lsauer1/ITP-470-Smart-Home/photos/vccPin.jpg

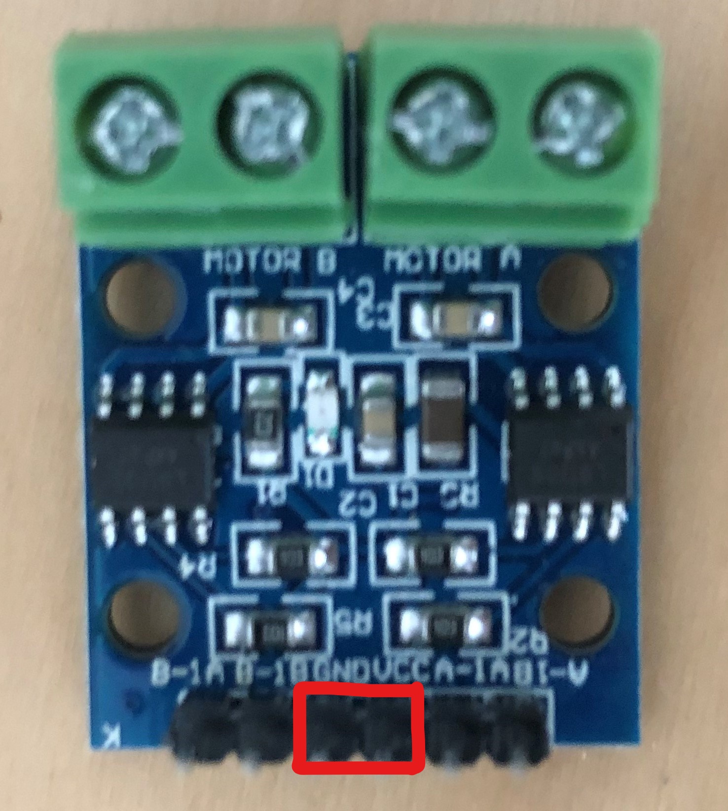
photos/vccPin.jpg
