lsauer1/ITP-470-Smart-Home/photos/motorPin.jpg

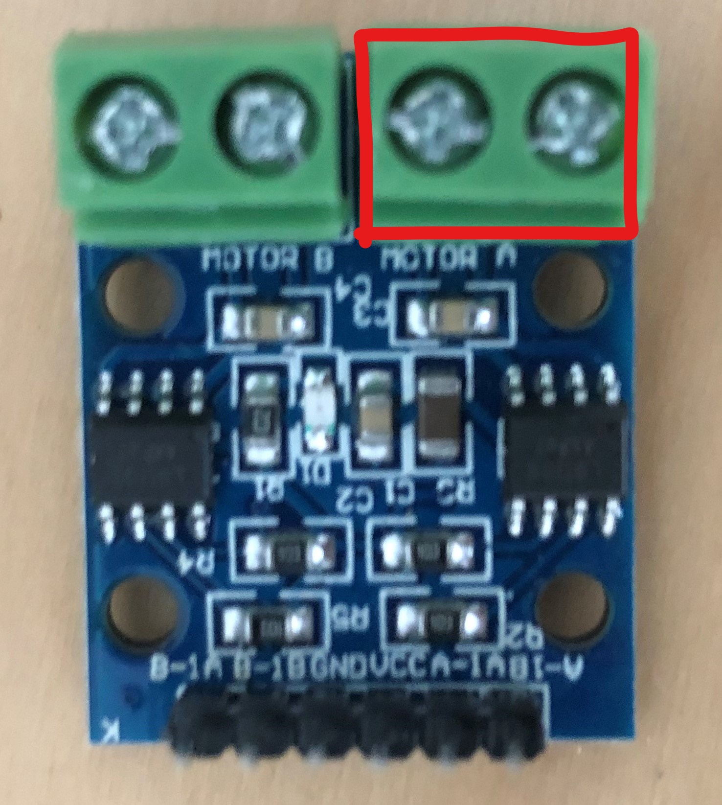
photos/motorPin.jpg
