lsauer1/ITP-470-Smart-Home/BOM.xlsx

Part | Link | Cost | Quanitity | Total Cost | Total Cost | $13.96
Motor and Mount | https://www.amazon.com/gp/product/B078MR3H45/ref=ppx_yo_dt_b_asin_title_o05_s00?ie=UTF8&psc=1 | $12.99 | 0.1 | $1.30
Motor Controller | https://www.amazon.com/gp/product/B00M0F243E/ref=ppx_yo_dt_b_asin_title_o00_s00?ie=UTF8&psc=1 | $7.49 | 0.2 | $1.50
Arduino ESP32 | https://www.amazon.com/gp/product/B0718T232Z/ref=ppx_yo_dt_b_asin_title_o07_s00?ie=UTF8&psc=1 | $10.99 | 1 | $10.99
Wires | https://www.amazon.com/Elegoo-EL-CP-004-Multicolored-Breadboard-arduino/dp/B01EV70C78?cv_ct_cx=arduino+wires | $6.98 | 0.025 | $0.17
