lsauer1/ITP-470-Smart-Home/TimeKeeping.xlsx

Day | Number of Hours | Week | Description | Week | Number of Hours | Total
2020-05-20 | 4 | 1 | Began looking at services that are capable of giving information to arduinos through more secure connections. I found a server called AdafruitIO which will let me send and read feed data through JSON requests, and also control devices through a native dashboard. I spent a lot of time comparing this versus making my own webpage, and while I will likely do so down the line, this service will work for now. I spent the rest of the time setting up my account and the feeds (the documentation is quite poor) | 1 | 16 | 204
2020-05-22 | 4.5 | 1 | Started working on a sample program that simply reads data from a feed and outputs any new messages to Serial. However, since I am working with arduino clones from china, it took quite a whilke before I was able to get the firmware working for even a basic wifi connection to occur. I was able to in the end get the device to connect to wifi, but there is still more work to do to get it to read messages from the server. | 2 | 12
2020-05-23 | 3.5 | 1 | I finished the sample program from earlier. It is capable from accepting a feed from online and reading out any strings sent. I plan to use one feed per device and setup string parsing functions to convert the inputs to data. I also began investigating the alexa developer console and got my account setup. | 3 | 18
2020-05-24 | 4 | 1 | I did a lot of research to try and figure out how to write custom commands to send json requests from alexa, but am still facing a lot of issues getting the code to run properly on their servers. In the meantime, I started looking at how people have made these work in the past. Through this I was able to learn how to set up IFTTT to pass basic messages to AdafruitIO. Through this I was able to make a simple command that can be read from the arduino. However, I still need to figure how to send custom data (e.x. set brightness to 90). | 4 | 15
2020-05-29 | 3 | 2 | Began looking online for compoenents that will be needed for later parts of the project. I found a cost-effective stepper motor and contoller module and a cheap current sensor module for detecting limits. As a backup I have also considered looking into all effect sensors and magnets as other stops. | 5 | 18
2020-05-31 | 4 | 2 | I received the motor controllers annd was able to make a simple program to run them. However, it appears that the motors listed current draw is much lower than the actual, and the current sensor will not work as a result. (Still not really sure why this is the case) | 6 | 29
2020-06-02 | 3 | 2 | Created and troubleshooted a program that moves to a position as defined by AdafruitIO (demo for week two). There are still some current draw issues and so the motor controller is have issues with reliabile stepping. I am hoping that with better currents sensors and power supplies, I should be able to fix this problem. | 7 | 38
2020-06-03 | 2 | 2 | Began designing the slides that will operate a basic light switch. | 8 | 24
2020-06-05 | 4 | 3 | I began investigating the AdafruitIO html requests. I installed a program called postman which allows me to simulate html requests. Using this I was able to send data from my computer to the feeds via html post requests. This helped me format my data so that the values I sent an be properly interpreted and stopped sending 422 Error values. | 9 | 15
2020-06-07 | 3.5 | 3 | I created a simple website capable accepting a text box input and sending whatever is inputted directly to the adafruit console. Again it took a lot to format data, especially the header of the html request. | 10 | 8
2020-06-08 | 5.5 | 3 | I began resetting my alexa accounts. I realized after edditing that I needed a new account as I couldn't use console.log. I spent a lot of time setting this up as well as learning the various tools need for the alexa developer console, the syntax, and their html code. | 11 | 11
2020-06-10 | 5 | 3 | I was able to make working code to take alexa input and submit that value to adafruit-io. | 0
2020-06-12 | 4 | 4 | I began researching ways to add the accessibility device that was discussed earlier in the course. I found that while I wanted to keep usig arduino, the processing power wasn't high enough for image recogonition which is necessary for reading oven displays. At first I looked all over for an arduino with enough power, but they were all very expensive and the goal was to make an accessible and cheap option. After that I started looking into using a raspberry pi zero W, which is small, can handle image processing, and is less expensive.
2020-06-14 | 5 | 4 | While I wait for the raspberry pi to arrive I looked for libraries online to handle number recognition. At first I was looking for a text recognition library, but they are all quite complicated and meant more for handwritting recognition. As a result they tend to be much more complicated that what I was looking for. After a while I found a library called SSOCR (Seven Segment Optical Character Recognition). This is perfect as most ovens use seven segment displays, and in fact so do most other appliances. The primary use was for reading serial output displays so it was built with something like this in mine.
2020-06-16 | 3 | 4 | After finding an acceptable library I started reaeraching t find guides on how it worked. It took a while (seeing as I am not particuarly expirenced with raspberry pi), but I found a guide that was easier to understand. I also started looking at their documentation so I could easily adapt once the raspberry pi arrives tomorrow.
2020-06-17 | 3 | 4 | I got the raspberry pi today and started setting it up. I flashed it with a Raspbian Jessie operating system and started installing all the depeandancies for the library. This got really complicated due to the fact that I am currently at someone else's house and their firewall was interfereing with certain downloads. Eventually I was able to figure it out and I was succesfull in running their example!
2020-06-20 | 4 | 5 | I went back into the example given and tried to make it work for other images, but started to have lots of difficulty. Right now I am SSHing into the raspberry pi to program it, but this means that I am incapable of seeing the image and the iage after its processed by the library. Therefore, it got incredibly hard to debug and I will need to take a break until I can get access to my monitor again. In the meantime I emailed my ITP 303 professor and got permission to build our final project as the website for this class.
2020-06-21 | 8 | 5 | I wanted to create a secure method for login for the website since security for smart homes is always a concern. I decided to use google oauth2 as a login system and started working on intergrating that to a basic website. However, the last time I did this was on a ruby based website (sinatra) and very little of my previous expirence was applicable. In the end I was able to create a button with log in functionaility, but I can't find where the user information was returned and the event handlers were making it hard to create a logout button.
2020-06-22 | 6 | 5 | I was able to finish the google login system. I found a way to report and save the user email (the primary key in the user database) to session storage. I also started designing the database to hold the websites information.
2020-06-26 | 5 | 6 | I began work on fully filling out the website today. I first started with selecting the style I wanted (dark blue and white), and by getting my bootstrap navbar setup. I also copied over the google login code from the earlier week.
2020-06-27 | 8 | 6 | Today I began working on the user page. I began with creating a new account page that auto fills from google and then working on svaing that to a mysql databse. Then I used session data to verify your google email and that email were the same. Finding the way to pass the javascript google data to the php side was complicated but I created an invisible form which seemed to work.
2020-06-29 | 9 | 6 | I began the household page today, the first page has a list of households with the option to make one. I then made a info page for specific housheolds that will contain a list of devices and users in that household.
2020-07-01 | 7 | 6 | I began the devices page today, which is complicated as it must integrate with adafruit io. I was able to find a way to send CURL requests through php to create new feeds whenever a new device is created. In addition, by selecting a device you can send a new command and see the last ten commands.
2020-07-03 | 5 | 7 | I continued to work on the device page today, for some reason sending the commands no longer works, I suspect the form data is not coming in correctly, but I was unable to figure it out today.
2020-07-04 | 6 | 7 | I figure it out! I had multiple forms with the same id on the page and so not all the forms were working. Once I fixed it I made the page adjustable for various screen sizes.
2020-07-06 | 15 | 7 | Today I went back and made all the pages adjustable based on screensizes and added delet pages for every table item.
2020-07-07 | 12 | 7 | Final bug fixes and styling on the wbeiste, I worked for a couple hours today just trying to get the routines page working, but I need more time to fully figure it out.
2020-07-11 | 8 | 8 | Cadded and printed new motor mount for DC motor rather than stepper motor. I tried to create a system to run on a belt and pulley to drag the slider along the rails, but the frictionw asn't sufficent to spin the belt.
2020-07-13 | 8 | 8 | After figuringing out that a belt and pulley would not work I created a leadscrew using a 3D printed screw and a ziptie. This works for dragging the slider.
2020-07-14 | 6 | 8 | I started looking into how I would control the motors and saw that the ESP32 pins have a 3V PWM output. I originally tried using this to power the motors, but the current was insufficent.
2020-07-17 | 2 | 8 | I attempted to use transistors and a DC outlet to increase the amperage but was ultimately unsuccesful as my arduino appears to have been fried
2020-07-21 | 5 | 9 | The new arduino just arrived and I can now resume work, I started by attempting to use the transistors again. While this method works, the circuit is rather complicated and prone to failure due to bad connections. I may look in to attempting to use the L298N
2020-07-22 | 1900-01-04 | 9 | After yesterday I realized that since the tranistors can only control the speed in one direction, they would ultimatlely be too complicated to control both directions for on and off. I have hooked back up a L298N and am using that to control the motors.
2020-07-24 | 5 | 9 | After my flight back home it appears that I am missing the NPN transistors and the L298N's I have been using. I attempted to make the cicruit work again using transistors I found around my house but theyre current limit was much too low. I have generated code to simulate the speed control from alexa and ordered a replacement L298N.
2020-07-27 | 5 | 10 | The new L298N's seem to also be having issues, they will work for a bit but their huge voltage inut requirement is causing issues with them overheating and stopping working. After a coupel hours of troubleshooting I gave up and decided I would start to look for new motor controllers while I continued.
2020-07-28 | 3 | 10 | I did some reaserch to find motor controllers that do not lose as much voltage and ordered them. I also began working on the documentation for the project
2020-08-02 | 3 | 11 | I received the new motor controllers and connected them. They work off the bat but if supplied with too much current have a tendancy to overheat. However, since most people do not constantly switch their lights on and off this should be okay. Since we do not have power or wifi I cannot test them with alexa yet, but I continued working on documentaiton
2020-08-11 | 4 | 11 | We just got power and wifi so I tested with alexa and began uploading researching new ways to host the website likely through heroku.
2020-08-12 | 4 | 11 | I finished uploading everything to github and finalized all code segments. I began working on hosting the website but it is complicated.
