lsauer1/ITP-470-Smart-Home/CAD Files/STL/Slider.stl

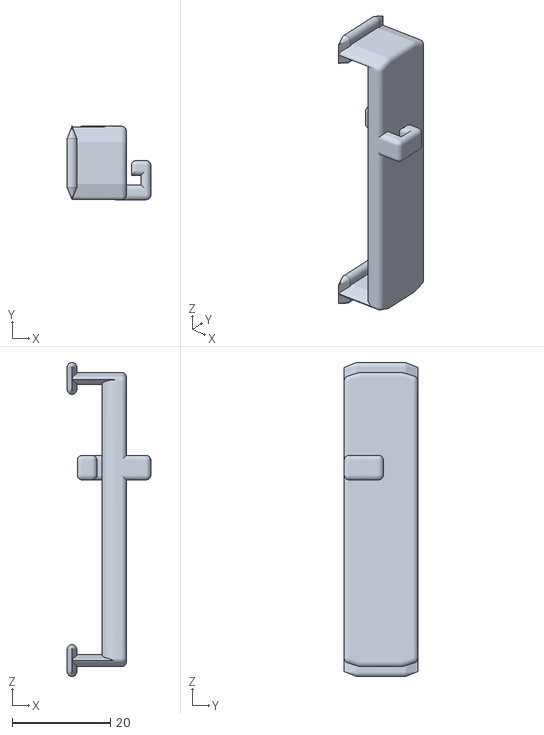
[picture p3: CAD file, 2020-08-12]
CAD Files/STL/Slider.stl
17.1 x 15.0 x 64.0
