lsauer1/ITP-470-Smart-Home/CAD Files/STL/BasePart2.stl

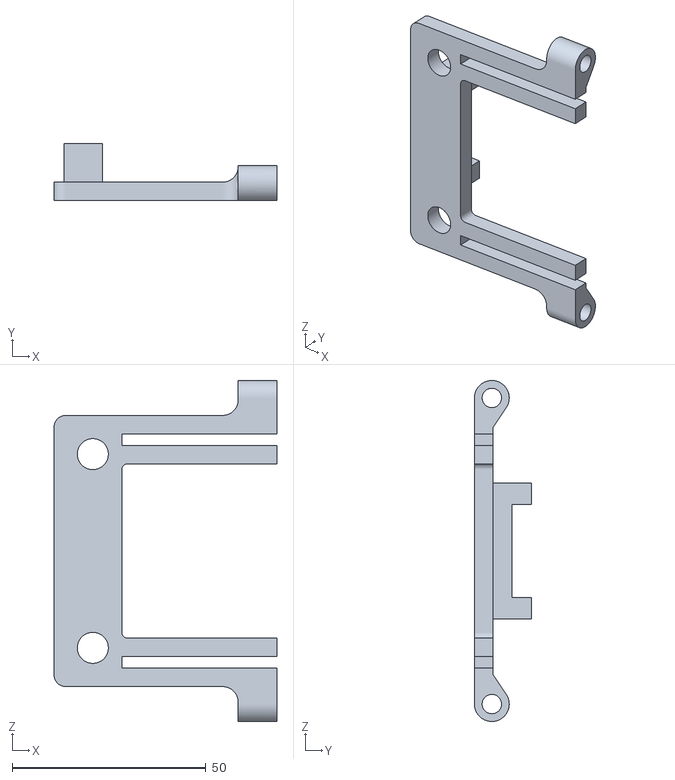
[picture p4: CAD file, 2020-08-12]
CAD Files/STL/BasePart2.stl
57.5 x 14.8 x 88.0
