lsauer1/ITP-470-Smart-Home/CAD Files/STL/BasePart1.stl

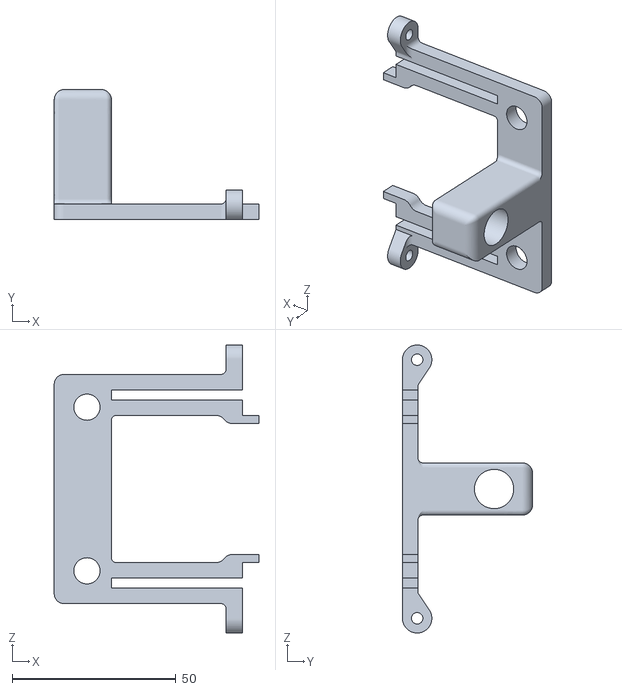
[picture p5: CAD file, 2020-08-12]
CAD Files/STL/BasePart1.stl
62.5 x 39.8 x 88.0
