lsauer1/ITP-470-Smart-Home/CAD Files/STL/Rails.stl

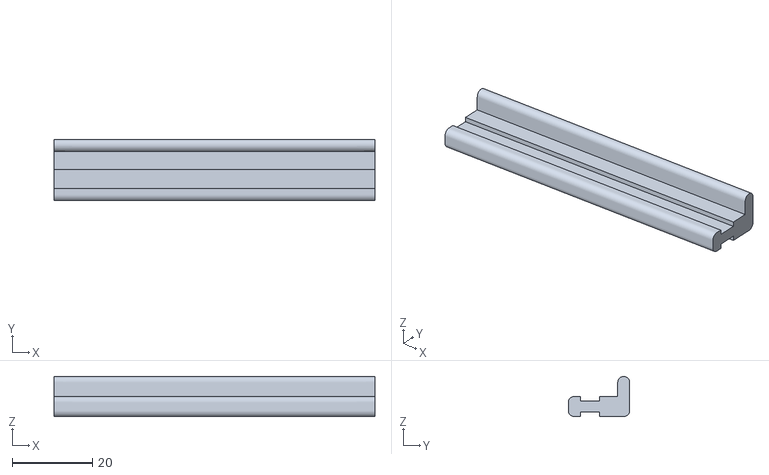
[picture p6: CAD file, 2020-08-12]
CAD Files/STL/Rails.stl
80.0 x 15.3 x 10.0
