lsauer1/ITP-470-Smart-Home/CAD Files/STL/Leadscrew.stl

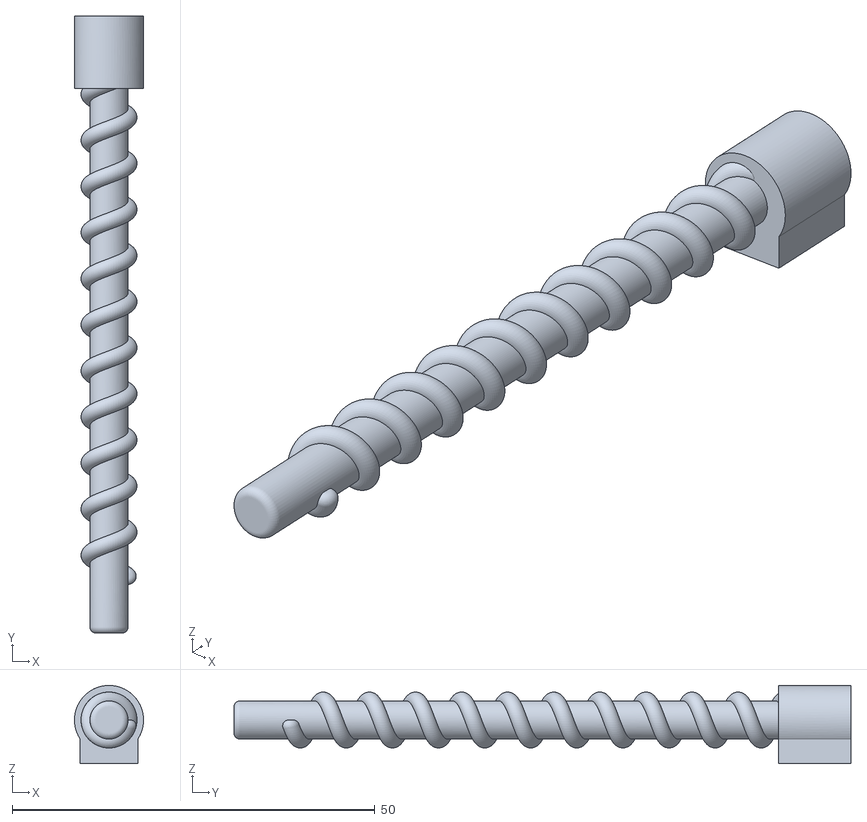
[picture p7: CAD file, 2020-08-12]
CAD Files/STL/Leadscrew.stl
9.52 x 85.0 x 10.8
