lsauer1/ITP-470-Smart-Home/(list of files, cad)

Other CAD files:
CAD Files/BasePart1.ipt
CAD Files/BasePart2.ipt
CAD Files/Leadscrew.ipt
CAD Files/Rails.ipt
CAD Files/Slider.ipt
