lsauer1/ITP-470-Smart-Home/(commit log)

2020-08-12 Upload Website, timekeeping, and arduino
    [TimeKeeping.xlsx]
2020-08-12 adding cad files
    [BasePart1.ipt, BasePart1.stl, BasePart2.ipt, BasePart2.stl, Leadscrew.ipt, Leadscrew.stl, Rails.ipt, Rails.stl]
